davidledwards/gps-clock/etc/gps-clock-breadboard.png

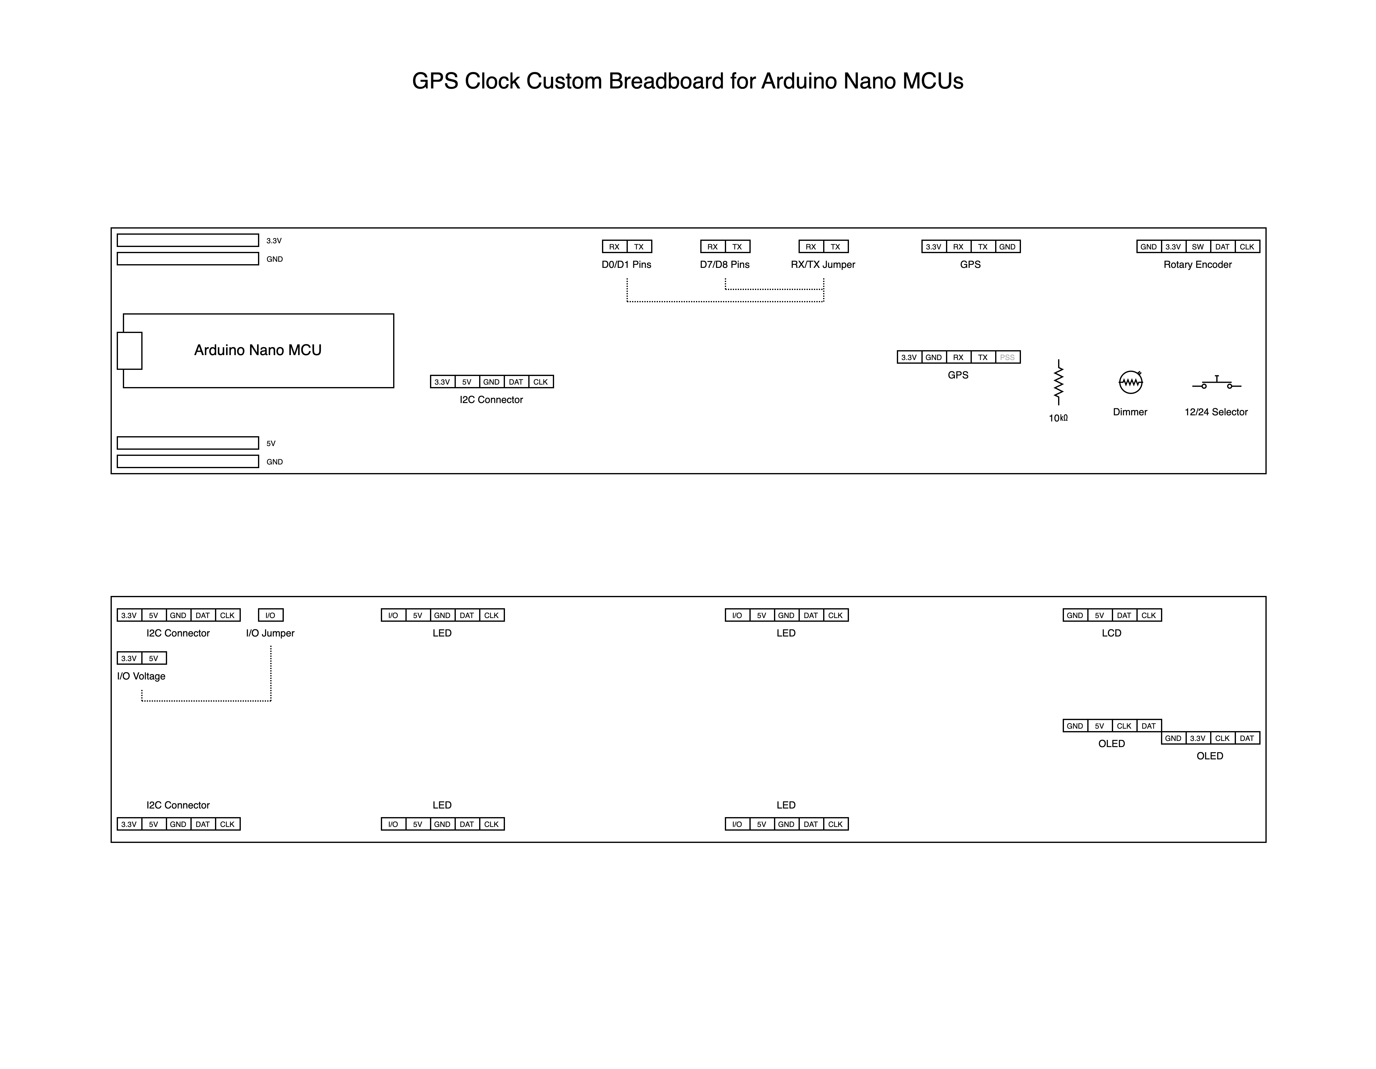
etc/gps-clock-breadboard.png
