davidledwards/gps-clock/(threads)

Thread 1 (2020-08-18):

Add button to control 12/24 hour time format

davidledwards, 2020-08-18:
Add a simple push button to toggle between 12- and 24-hour format. There should be some visual indication, such as using the trailing period on the time display to indicate AM/PM. The button can easily be mounted on the GPS board.

Closed 2020-09-16.

Thread 2 (2020-08-18):

Add button to select brightness level

davidledwards, 2020-08-18:
The idea is to capture a use-defined upper bound on the brightness level. The photocell would continue to automatically adjust the brightness level based on ambient light, but the range would be bounded by the selection from the user.

Consider 3 levels of brightness. The normal range for LEDs is 0-15. The initial state would be 15 as the upper bound, which implies the full range of levels. A first push of the button would reduce the range, e.g. 0-11. A second push of the button would further reduce the range, e.g. 0-7. A third push would return to the full range, 0-15.

The button could be mounted on the GPS board.

davidledwards, 2020-09-16:
Decided not to implement this feature as it does not add much value to the user experience.

Closed 2020-09-16.

Thread 3 (2020-09-07):

Rotary encoder button should use pull-up resistor

davidledwards, 2020-09-07:
The push button on the rotary encoder is not properly using a pull-up resistor. It is wired when closed to pull to ground, but the pin on the Uno board is not configured as INPUT_PULLUP.

davidledwards, 2020-09-07:
After examination of the source code associated with the library used to interface with the encoder, it turns out that that pins are being properly configured.

Closed 2020-09-07.

Thread 4 (2020-09-07):

Reduce debouncing period of rotary encoder

davidledwards, 2020-09-07:
The original debouncing period was 200ms, but this is causing turns of the encoder to be missed and appearing to unresponsive.

Closed 2020-09-07.

Thread 5 (2024-08-09):

Add support for Ardunio Nano 33 IoT board

davidledwards, 2024-08-09:
This is the same form factor as the Nano, but increase flash memory to 256K and SRAM to 32K. Unfortunately, there is no EEPROM, so we may need to disable the storage of timezone information.

davidledwards, 2024-08-09:
Regarding lack of EEPROM, it appears that we can use an emulation library that stores the data in the SAMD flash memory.

https://forum.arduino.cc/t/persistent-storage-for-arduino-nano-33-iot-no-eeprom/623137/2

davidledwards, 2024-08-26:
Formally supported as of version 5.0.

https://github.com/davidledwards/gps-clock/tree/5.0

Thread 8 (2024-08-26):

Add support for Arduino Nano Every

davidledwards, 2024-08-26:
This is a lower cost option that the Nano 33 IoT, but importantly, has more SRAM (6K) compared to the Uno and Nano (2K). This board would support the OLED display, which does not work on the Uno and Nano. The stack overflows and clobbers memory simply due to the limited RAM size.

davidledwards, 2024-09-09:
Supported in the 5.2 release.

https://github.com/davidledwards/gps-clock/tree/5.2

Closed 2024-09-09.

Thread 9 (2024-08-28):

Add support for Arduino Nano BLE

davidledwards, 2024-08-28:
This is a lower cost option that the Nano 33 IoT, but importantly, has considerably more SRAM (256K) compared to the Uno and Nano (2K). This board would support the OLED display, which does not work on the Uno and Nano. The stack overflows and clobbers memory simply due to the limited RAM size.

davidledwards, 2024-08-28:
Pushing commits to a temporary branch.

https://github.com/davidledwards/gps-clock/tree/nano-ble

davidledwards, 2024-09-09:
Supported in the 5.2 release.

https://github.com/davidledwards/gps-clock/tree/5.2

Closed 2024-09-09.
