davidledwards/gps-clock/timezones.cpp

/*
 * Copyright 2021 David Edwards
 *
 * Licensed under the Apache License, Version 2.0 (the "License");
 * you may not use this file except in compliance with the License.
 * You may obtain a copy of the License at
 *
 * http://www.apache.org/licenses/LICENSE-2.0
 *
 * Unless required by applicable law or agreed to in writing, software
 * distributed under the License is distributed on an "AS IS" BASIS,
 * WITHOUT WARRANTIES OR CONDITIONS OF ANY KIND, either express or implied.
 * See the License for the specific language governing permissions and
 * limitations under the License.
 */
#include "timezones.h"
#include "board.h"

// Array of predefined timezones where first entry must always be "UTC", thus array size is
// guaranteed to be greater than zero. It should be safe to always reference first element.
//
// Note that names assigned to timezone change rules are irrelevant, so these are initialized
// as empty strings to minimize consumption of RAM.
//
// Number of timezones depends on available RAM.
static const tz_info TZ_TABLE[] = {
  tz_info {
    "UTC",
    Timezone(
      TimeChangeRule {"", Last, Sun, Mar, 1, 0}
    )
  },
#if RAM_SIZE > 2
  // Australian Central Standard Time
  tz_info {
    "ACST",
    Timezone(
      TimeChangeRule {"", First, Sun, Oct, 2, 570}
    )
  },
  // Australian Central Standard/Daylight Time
  tz_info {
    "ACST/ACDT",
    Timezone(
      TimeChangeRule {"", First, Sun, Apr, 2, 630},
      TimeChangeRule {"", First, Sun, Oct, 2, 570}
    )
  },
  // Australian Eastern Standard Time
  tz_info {
    "AEST",
    Timezone(
      TimeChangeRule {"", First, Sun, Oct, 2, 600}
    )
  },
  // Australian Eastern Standard/Daylight Time
  tz_info {
    "AEST/AEDT",
    Timezone(
      TimeChangeRule {"", First, Sun, Apr, 2, 660},
      TimeChangeRule {"", First, Sun, Oct, 2, 600}
    )
  },
  // Alaska Standard/Daylight Time
  tz_info {
    "AKST/AKDT",
    Timezone(
      TimeChangeRule {"", Second, Sun, Mar, 2, -540},
      TimeChangeRule {"", First, Sun, Nov, 2, -480}
    )
  },
  // Atlantic Standard/Daylight Time
  tz_info {
    "AST/ADT",
    Timezone(
      TimeChangeRule {"", Second, Sun, Mar, 2, -240},
      TimeChangeRule {"", First, Sun, Nov, 2, -180}
    )
  },
  // Australian Western Standard Time
  tz_info {
    "AWST",
    Timezone(
      TimeChangeRule {"", First, Sun, Oct, 2, 480}
    )
  },
  // Beijing Time
  tz_info {
    "BJT",
    Timezone(
      TimeChangeRule {"", First, Sun, Oct, 2, 480}
    )
  },
  // Central Africa Time
  tz_info {
    "CAT",
    Timezone(
      TimeChangeRule {"", First, Sun, Oct, 2, 120}
    )
  },
#endif
  // Central European/Summer Time
  tz_info {
    "CET/CEST",
    Timezone(
      TimeChangeRule {"", Last, Sun, Mar, 2, 120},
      TimeChangeRule {"", Last, Sun, Oct, 2, 60}
    )
  },
#if RAM_SIZE > 2
  // Chatham Standard/Daylight Time
  tz_info {
    "CHAST/CHADT",
    Timezone(
      TimeChangeRule {"", Last, Sun, Sep, 2, 825},
      TimeChangeRule {"", First, Sun, Apr, 2, 765}
    )
  },
#endif
  // Central Standard/Daylight Time (US)
  tz_info {
    "CST/CDT",
    Timezone(
      TimeChangeRule {"", Second, Sun, Mar, 2, -300},
      TimeChangeRule {"", First, Sun, Nov, 2, -360}
    )
  },
#if RAM_SIZE > 2
  // Eastern Africa Time
  tz_info {
    "EAT",
    Timezone(
      TimeChangeRule {"", First, Sun, Oct, 2, 180}
    )
  },
#endif
  // Eastern European Time
  tz_info {
    "EET",
    Timezone(
      TimeChangeRule {"", Last, Sun, Oct, 2, 120}
    )
  },
  // Eastern European/Summer Time
  tz_info {
    "EET/EEST",
    Timezone(
      TimeChangeRule {"", Last, Sun, Mar, 2, 180},
      TimeChangeRule {"", Last, Sun, Oct, 2, 120}
    )
  },
  // Eastern Standard/Daylight Time (US)
  tz_info {
    "EST/EDT",
    Timezone(
      TimeChangeRule {"", Second, Sun, Mar, 2, -240},
      TimeChangeRule {"", First, Sun, Nov, 2, -300}
    )
  },
#if RAM_SIZE > 2
  // Indochina Time
  tz_info {
    "ICT",
    Timezone(
      TimeChangeRule {"", First, Sun, Oct, 2, 420}
    )
  },
  // Indian Standard Time
  tz_info {
    "IST",
    Timezone(
      TimeChangeRule {"", First, Sun, Nov, 2, 330}
    )
  },
  // Japan Standard Time
  tz_info {
    "JST",
    Timezone(
      TimeChangeRule {"", First, Sun, Nov, 2, 540}
    )
  },
  // Hawaii Standard Time
  tz_info {
    "HST",
    Timezone(
      TimeChangeRule {"", First, Sun, Nov, 2, -600}
    )
  },
  // Hawaii Standard/Daylight Time
  tz_info {
    "HST/HDT",
    Timezone(
      TimeChangeRule {"", Second, Sun, Mar, 2, -540},
      TimeChangeRule {"", First, Sun, Nov, 2, -600}
    )
  },
  // Moscow Standard Time
  tz_info {
    "MSK",
    Timezone(
      TimeChangeRule {"", First, Sun, Oct, 2, 180}
    )
  },
  // Mountain Standard Time (US)
  tz_info {
    "MST",
    Timezone(
      TimeChangeRule {"", First, Sun, Nov, 2, -420}
    )
  },
#endif
  // Mountain Standard/Daylight Time (US)
  tz_info {
    "MST/MDT",
    Timezone(
      TimeChangeRule {"", Second, Sun, Mar, 2, -360},
      TimeChangeRule {"", First, Sun, Nov, 2, -420}
    )
  },
#if RAM_SIZE > 2
  // New Zealand Standard/Daylight Time
  tz_info {
    "NZST/NZDT",
    Timezone(
      TimeChangeRule {"", Last, Sun, Sep, 2, 780},
      TimeChangeRule {"", First, Sun, Apr, 2, 720}
    )
  },
  // Phillipine Standard Time
  tz_info {
    "PHST",
    Timezone(
      TimeChangeRule {"", First, Sun, Oct, 2, 480}
    )
  },
  // Pakistan Standard Time
  tz_info {
    "PKT",
    Timezone(
      TimeChangeRule {"", First, Sun, Oct, 2, 300}
    )
  },
#endif
  // Pacific Standard/Daylight Time (US)
  tz_info {
    "PST/PDT",
    Timezone(
      TimeChangeRule {"", Second, Sun, Mar, 2, -420},
      TimeChangeRule {"", First, Sun, Nov, 2, -480}
    )
  },
#if RAM_SIZE > 2
  // South African Standard Time
  tz_info {
    "SAST",
    Timezone(
      TimeChangeRule {"", First, Sun, Oct, 2, 120}
    )
  },
  // Samoa Standard Time
  tz_info {
    "SST",
    Timezone(
      TimeChangeRule {"", First, Sun, Oct, 2, 480}
    )
  },
  // West Africa Time
  tz_info {
    "WAT",
    Timezone(
      TimeChangeRule {"", First, Sun, Oct, 2, 60}
    )
  },
  // Western European Time
  tz_info {
    "WET",
    Timezone(
      TimeChangeRule {"", First, Sun, Oct, 2, 0}
    )
  },
  // Western European/Summer Time
  tz_info {
    "WET/WEST",
    Timezone(
      TimeChangeRule {"", Last, Sun, Mar, 2, 60},
      TimeChangeRule {"", Last, Sun, Oct, 2, 0}
    )
  },
#endif
};

// Number of timezones.
static const size_t TZ_TABLE_SIZE = sizeof(TZ_TABLE) / sizeof(tz_info);

tz_database::tz_database() {
}

size_t tz_database::size() const {
  return TZ_TABLE_SIZE;
}

const tz_info* const tz_database::find(const char* name) const {
  return &TZ_TABLE[find_index(name)];
}

size_t tz_database::find_index(const char* name) const {
  for (size_t i = 0; i < TZ_TABLE_SIZE; ++i) {
    if (strcmp(TZ_TABLE[i].name, name) == 0)
      return i;
  }
  return 0;
}

const tz_info* const tz_database::get(size_t index) const {
  return &TZ_TABLE[index < TZ_TABLE_SIZE ? index : 0];
}
