davidledwards/gps-clock/gpsdisplay.h

/*
 * Copyright 2021 David Edwards
 *
 * Licensed under the Apache License, Version 2.0 (the "License");
 * you may not use this file except in compliance with the License.
 * You may obtain a copy of the License at
 *
 * http://www.apache.org/licenses/LICENSE-2.0
 *
 * Unless required by applicable law or agreed to in writing, software
 * distributed under the License is distributed on an "AS IS" BASIS,
 * WITHOUT WARRANTIES OR CONDITIONS OF ANY KIND, either express or implied.
 * See the License for the specific language governing permissions and
 * limitations under the License.
 */
#ifndef __GPSDISPLAY_H
#define __GPSDISPLAY_H

#include <Arduino.h>
#include "config.h"
#include "gps.h"
#include "timezones.h"

#if defined(GPS_DISPLAY_LCD)
#if defined(LCD_GENERIC)
#include <LiquidCrystal_PCF8574.h>
#elif defined(LCD_ADAFRUIT)
#include <Adafruit_LiquidCrystal.h>
#endif
#elif defined(GPS_DISPLAY_OLED)
#include <Adafruit_SSD1306.h>
#endif

class gps_display {
public:
  gps_display();
  void show_info(const gps_info& info, const gps_time& time);
  void show_searching();
  void show_tz(const tz_info* tz, bool pending);
  void show_display(bool on);

private:
#if defined(GPS_DISPLAY_LCD)
#if defined(LCD_GENERIC)
  LiquidCrystal_PCF8574 display;
#elif defined(LCD_ADAFRUIT)
  Adafruit_LiquidCrystal display;
#endif
#elif defined(GPS_DISPLAY_OLED)
  Adafruit_SSD1306 display;
#endif

  bool searching;
  bool displaying;

  void write_lat(const gps_info& info);
  void write_lon(const gps_info& info);
  void write_altitude(const gps_info& info);
  void write_satellites(const gps_info& info);
  void write_utc(const gps_time& time);
  void write_year(const gps_time& time);
  void write_month(const gps_time& time);
  void write_day(const gps_time& time);
  void write_tz(const tz_info* tz, bool pending);
  void clear_gps();
  void clear_row(uint8_t row, uint8_t col = 0);
  void set_cursor(uint8_t col, uint8_t row);
  void draw_bitmap(uint8_t col, uint8_t row, uint8_t* bitmap);
};

#endif
