davidledwards/gps-clock/(commit log)

2020-06-21 sort out peculiarities of arduino IDE compilation; rename sketch to _main.ino to ensure it gets picked up as the actual sketch file
2020-06-21 switched to arduino-cli for builds, rearranged project, and included hacked code as starting point
2020-06-29 get basic LED display to a functional state
2020-07-01 add support for the rotary encoder to select the timezone offset
2020-07-05 start documenting assembly process
2020-07-05 document more of the assembly process
2020-07-05 add table of contents; include view of arduino and GPS side by side
2020-07-05 fix bug in lower bound of timezone selection
    [tzselector.cpp]
2020-07-18 include final assembly images in README
2020-08-13 Squashed commit of the following:
    commit a3d2228c5f9ef15876f5f968ca7aa699e0ac5e53
    Author: David Edwards <david.l.edwards@gmail.com>
    Date: Thu Aug 13 11:33:18 2020 -0500
    add support for changing brightness level of LED display using photoresistor
2020-09-07 changed debounce delay of encoder to 5ms
2020-09-15 increased debounce delay for rotary encoder
2020-09-15 added button to toggle between 12/24 time format
2020-09-21 include circuit diagram
2021-01-25 fix bug where selector continued returning tz_propose after idle period expired
    [tzselector.cpp]
2021-06-03 fix compilation failure when not using make
    [gpsdisplay.h]
2021-06-14 update makefile to support MEGA board
2021-06-16 switch to TinyGPS library and simplify GPS read/parse loop
2021-07-05 make sure pin is configured with pullup resistor
2021-07-05 make nano the default board type
2021-07-17 add support for Mega board; add more time zones when compiling for Mega
2021-07-17 add more timezones for Mega board
2021-08-27 eliminate gpsconfig.h and move board/component/pin variations into specific class files
2021-08-28 fix regression: only show dot in 12-hour mode when hour is essentially PM
    [clockdisplay.cpp]
2021-11-10 add circuit diagram for clock built by Moldova contributor
2021-11-11 fix bug that was clobbering LCD display
    [gpsdisplay.cpp]
2021-11-12 adapt date format in LED display
2021-11-12 support absence of colon and date format in LED display
2021-11-12 add support for LED layout
2021-11-12 change date layout option to avoid conflict
    [clockdisplay.cpp, gpsdisplay.cpp]
2021-11-12 revert back to 2 seconds intervals before sampling GPS
    [gpsunit.cpp]
2021-11-13 fix incorrect macro name
    [clockdisplay.cpp]
2024-08-11 fix schematics where A4 and A5 pins were swapped
2024-08-15 first pass at source changes to support OLED and Nano 33 IoT board
2024-08-15 change LED configuration directive name; update documentation
2024-08-26 modernized LCD display with glyphs; fixed calculation error in altidude; cleaned up source code
    [gpsdisplay.cpp]
2024-08-26 make RX/TX pin defaults for Nano 33 IoT explicit
2024-08-30 add links to boards in predefined configs
2024-09-03 rename source files; prepare for Nano 33 BLE and Nano Every boards
2024-09-07 update circuit diagram to reflect voltage changes
2024-10-01 update documentation to show photos of PCB
2024-12-31 remove deprecated arduino-cli option
2025-01-13 add detail to AM/PM pin documentation
2025-01-13 update schematic with AM/PM pins
